Chess-nut/NovaRIde/IoT/NovaRide/PCB_PCB_bottomlayer.png

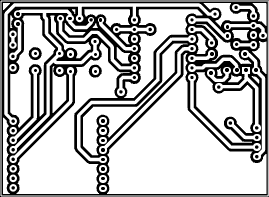
IoT/NovaRide/PCB_PCB_bottomlayer.png
