Chess-nut/NovaRIde/IoT/NovaRide/PCB_PCB_NovaRide_2026-10-28.png

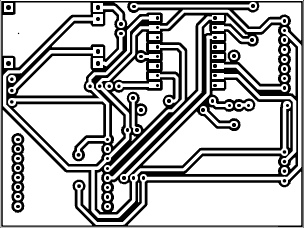
IoT/NovaRide/PCB_PCB_NovaRide_2026-10-28.png
