Chess-nut/NovaRIde/IoT/NovaRide/PCB_PCB_toplayer.png

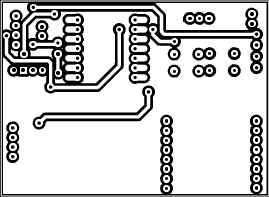
IoT/NovaRide/PCB_PCB_toplayer.png
