Chess-nut/NovaRIde/IoT/NovaRide/3D Files/MQ3_holder.stl

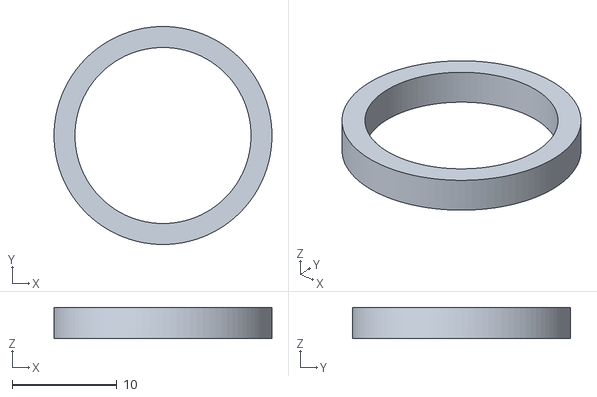
[picture p4: CAD file, 2026-10-30]
IoT/NovaRide/3D Files/MQ3_holder.stl
20.8 x 20.8 x 3.00
