Chess-nut/NovaRIde/IoT/NovaRide/3D Files/2_finger_gopro_mounting_piece_28mm_wide_finger_34mm_gap_3mm_base.stl

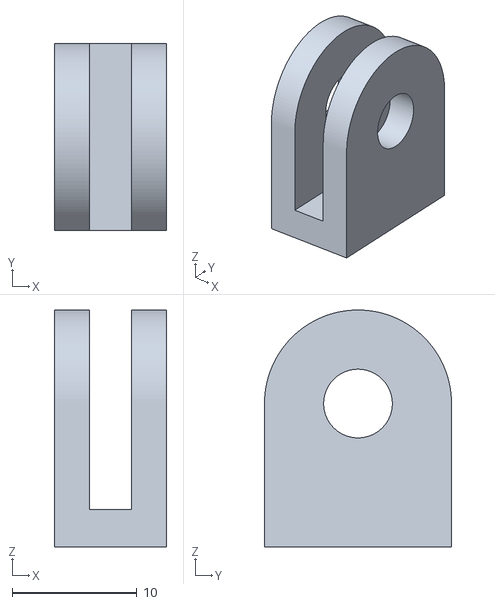
[picture p5: CAD file, 2026-10-30]
IoT/NovaRide/3D Files/2_finger_gopro_mounting_piece_28mm_wide_finger_34mm_gap_3mm_base.stl
9.00 x 15.0 x 19.0
