Chess-nut/NovaRIde/IoT/NovaRide/3D Files/Bottom.3mf

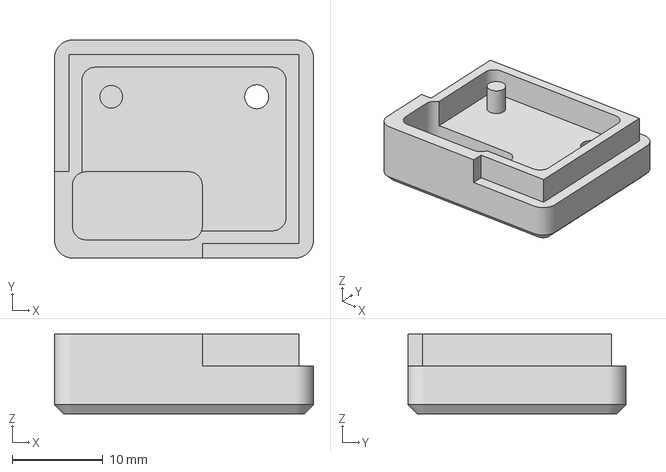
[picture p6: CAD file, 2026-10-30]
IoT/NovaRide/3D Files/Bottom.3mf
28.5 x 24.0 x 8.75 mm
