Chess-nut/NovaRIde/IoT/NovaRide/3D Files/TOP.3mf

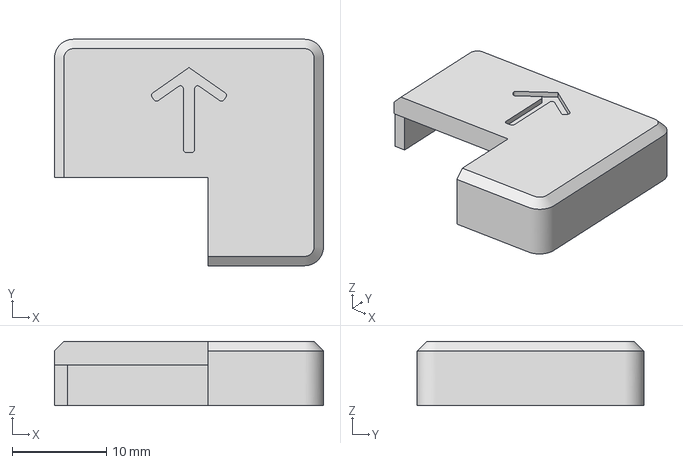
[picture p7: CAD file, 2026-10-30]
IoT/NovaRide/3D Files/TOP.3mf
28.5 x 24.0 x 6.80 mm
