Chess-nut/NovaRIde/IoT/NovaRide/3D Files/MOUNT.stl

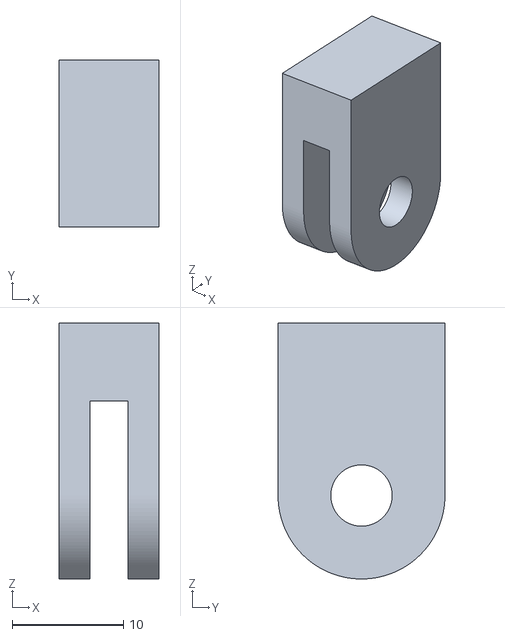
[picture p8: CAD file, 2026-10-30]
IoT/NovaRide/3D Files/MOUNT.stl
9.00 x 15.0 x 23.0
