Chess-nut/NovaRIde/IoT/NovaRide/3D Files/SweetProtection_Strutter_GoPro_Mount_v1.stl

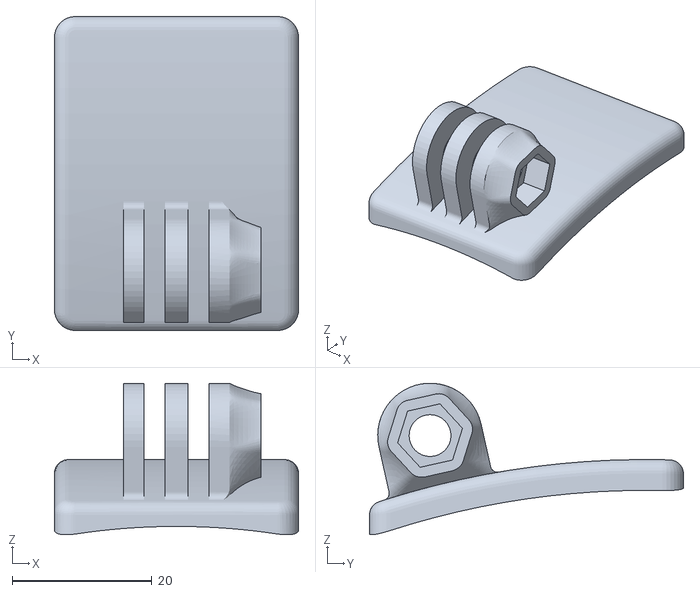
[picture p9: CAD file, 2026-10-30]
IoT/NovaRide/3D Files/SweetProtection_Strutter_GoPro_Mount_v1.stl
35.0 x 45.0 x 21.7
