Chess-nut/NovaRIde/IoT/NovaRide/3D Files/SW-420 Vibration Sensor Magnetic mount 8mm.stl

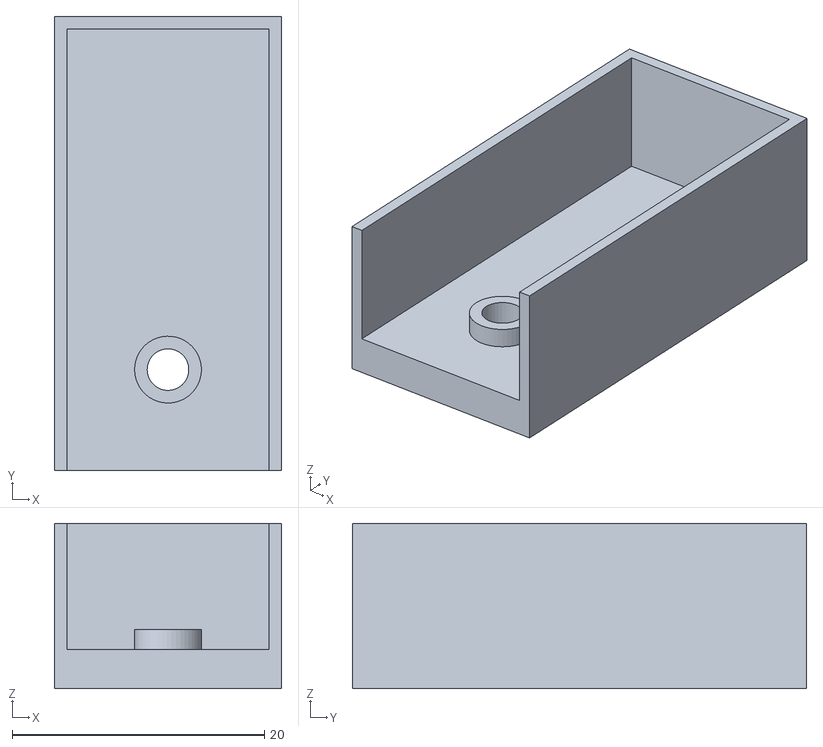
[picture p10: CAD file, 2026-10-30]
IoT/NovaRide/3D Files/SW-420 Vibration Sensor Magnetic mount 8mm.stl
18.0 x 36.0 x 13.1
