Chess-nut/NovaRIde/IoT/NovaRide/3D Files/caseV3.stl

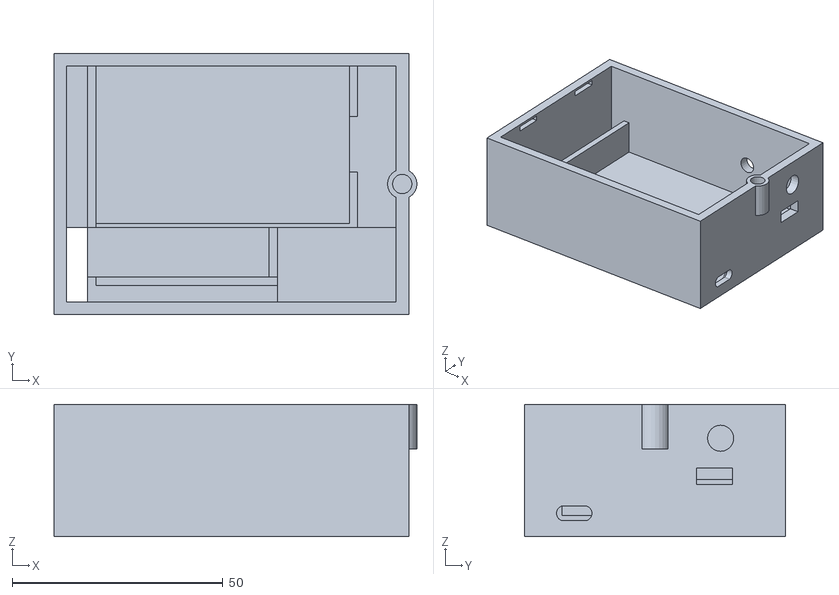
[picture p11: CAD file, 2026-10-30]
IoT/NovaRide/3D Files/caseV3.stl
86.0 x 61.9 x 31.3
