Chess-nut/NovaRIde/IoT/NovaRide/3D Files/case.stl

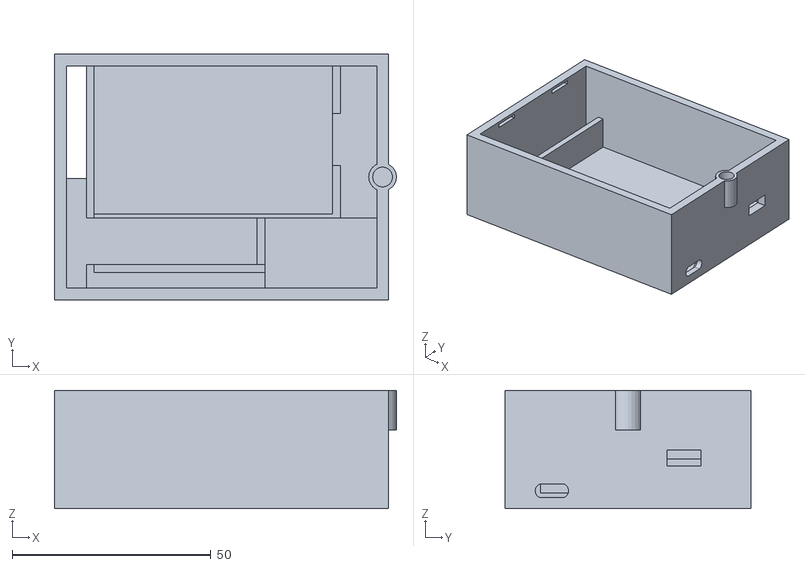
[picture p12: CAD file, 2026-10-30]
IoT/NovaRide/3D Files/case.stl
86.0 x 61.9 x 29.8
