Chess-nut/NovaRIde/IoT/NovaRide/3D Files/COVER.stl

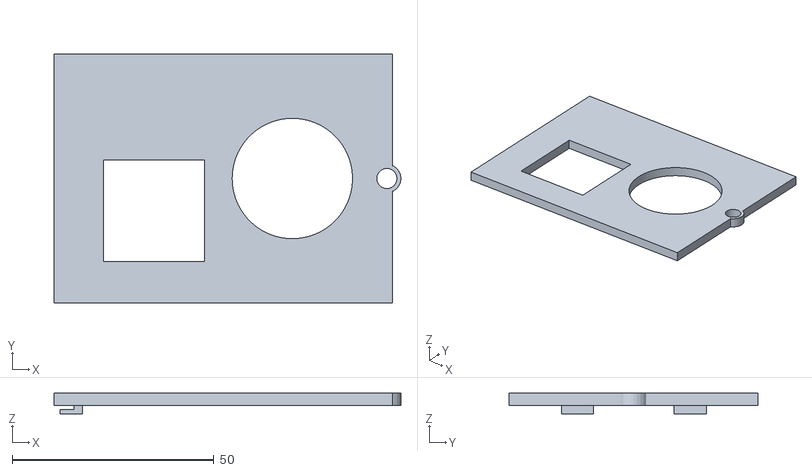
[picture p13: CAD file, 2026-10-30]
IoT/NovaRide/3D Files/COVER.stl
85.9 x 61.7 x 5.11
