Chess-nut/NovaRIde/(list of files, cad)

Other CAD files:
IoT/NovaRide/3D Files/caseV2.stl
IoT/NovaRide/3D Files/novaride.skp
