Chess-nut/NovaRIde/(commit log)

2026-07-29 innit: feat(admin): Phase 1 dashboard shell with mock fleet data
    Flutter Web operations console behind lib/main_admin.dart, sharing
    NovaColors with the rider app. No new pub dependencies, no Firebase.
    - shared/models: Rider, HelmetTelemetry, AlertEvent + status enums
    - admin/mock: 10 riders, matching telemetry, 5 alerts, weekly counts
    - AdminLoginPage (admin@novaride.ph / admin123) -> AdminShell
    - AdminShell: 240px sidebar (icon rail below 900px), topbar with LIVE
    indicator and admin chip, IndexedStack page switching, no router
    - DashboardPage: KPI row computed from the mock data, live fleet table
    (emergency rows red-tinted, alcohol over 0.05 in amber), map
    placeholder, alert feed, an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
2026-07-29 feat(admin): ArcGIS-style ops dashboard with live mock simulation
    Replaces the Phase 1 KPI-and-cards dashboard with a dense ops-console grid:
    a donut and an area chart flanking a large stylized fleet map, over a row of
    alert feed + two derived bar charts.
    All six panels read from one MockFleetController, so a simulated crash lands
    in the feed, flips a rider red on the map, and moves the donut and priority
    chart in the same frame. That controller is the seam Firebase streams plug
    into at Phase 4.
    - Shared DashPanel chrome and a single SimpleBarChartPainter behind all three
    bar charts; everything else hand-painted, no new dependencies.
    - AlertEvent gains an address; Rider/HelmetTelemetry g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
2026-08-08 feat(admin): rider CRUD with validation and roster filtering
2026-09-15 refactor(admin): extract FleetRepository seam
    Split the 635-line MockFleetController into a persistence contract and
    a source-agnostic controller so a cloud store can be swapped in without
    touching the pages.
    - lib/admin/data/fleet_repository.dart: FleetRepository interface —
    watch* streams as the source of truth, narrow write methods, and a
    FleetSource/FleetConnection surface for the top-bar chip.
    - lib/admin/data/mock_fleet_repository.dart: the simulation (jitter,
    alert spawner, stand-down rule) moved here unchanged. Streams deliver
    synchronously so controller and widget tests stay synchronous.
    - lib/admin/data/fleet_geography.dart: district table and map window,
    shared by the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
2026-09-15 feat(admin): Cloud Firestore repository with mock fallback
    The TNVS Operator console can now run on Cloud Firestore (project
    novaride-266bc) while keeping the in-process simulation as the
    zero-config default. Which one is live is shown in the top bar.
    - lib/admin/data/firestore_fleet_repository.dart: FleetRepository over
    riders/, devices/, alerts/ (orderBy timestamp, limit 100) and a
    history collection-group listener. Devices are joined to riders by
    helmetId; history is stitched onto alerts. Defensive parsing: missing
    fields default, unreadable documents are skipped with a debugPrint.
    Writes use update() with explicit paths or set(merge); a transition
    is one batch (status update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
2026-09-20 chore(admin): remove hardcoded Firebase project id
    The project moved from novaride-266bc to novaride-7a68c. Rather than swap
    one literal for another, FleetBootstrap.resolve() now returns a
    ConsoleBackend carrying the project id it read from
    assets/config/firebase.json, and the top bar's source tooltip shows that.
    The id no longer appears anywhere in lib/, so it cannot drift again.
    .firebaserc points at the new project. FIRESTORE_SCHEMA.md gets the new
    header and console link, notes that the old project's phantom users/*,
    emergencyalerts and devices/helmet01 structures are gone, flags that the
    composite indexes have to be deployed again, and closes the two §7 items
    that starting from an emp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
2026-09-20 feat(admin): Firebase Auth operator login with role claims and scoped rules
    Closes the panel comment "login - static only". The console's sign-in was
    a string comparison against three passwords in source, which is why the
    Firestore rules had to be deny-all: there was no principal to trust.
    Auth behind an interface, mirroring FleetRepository: AdminAuth with
    signIn / signOut / authStateChanges / currentUser. FirebaseAdminAuth is
    the real thing; LocalAdminAuth wraps the old demoAccounts so a checkout
    with no Firebase config - and every widget test - still signs in without
    the network. FleetBootstrap.resolve() now decides data source and auth
    together as one ConsoleBackend; AdminApp owns the si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
2026-09-20 feat(admin): production-grade operator login screen
    The login page listed every operator account with a role badge and a
    tap-to-fill row. That was a development convenience; on the front door
    of an operations console it reads as a prototype and hands an
    unauthenticated visitor the operator roster. The card is gone, on both
    paths, and the real operator emails it was built from
    (provisionedOperators) are gone from the repository with it.
    In its place, the things an operations tool actually has:
    - "Remember my email on this browser" keeps the last address — never
    the password — in localStorage via dart:js_interop (no package; an
    in-memory stub serves the VM), and a returning operator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
2026-09-20 fix(admin): resolve empty-state overflow at short viewport heights
    The Alerts page sized its KPI row to the page's outer width instead of
    the width inside its own 16px padding, so the fifth card was 32px short
    of fitting and wrapped onto a second row at every width — 170px taken
    from the queue below. On a 1366-wide window that is wide enough for the
    fixed-height layout and 633 tall, the queue's empty state was left a
    3px slot and overflowed. (At exactly 1280 the sidebar leaves the page
    under its 1100px breakpoint, so it scrolls and the stripe never shows;
    the observed size was a laptop mirroring the projector.)
    Three fixes, each structural rather than a smaller icon:
    - The KPI row is siz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
2026-09-20 feat(admin): persist rider registration and device pairing to Firestore
    Audit first: register, edit and deactivate already reached riders/ on
    the Firestore path (set-with-merge, update by field path, update), and
    survived a reload through the riders listener. Not rebuilt. What was
    missing: the helmet pairing was never written to devices/ (and the
    rules would have refused it); rider ids and helmet uniqueness were
    checked only against this console's copy of the roster; a plain write
    issued while offline queued forever with the rider on screen as saved;
    and a refused write showed the raw exception string.
    Repository (FirestoreFleetRepository): every roster write is one
    transaction. addRider cl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
2026-11-06 fix(admin): read every RTDB helmet node and replace the painted map
    - Merge deviceStatus, devices/{id}/safety|tracking|latest and the last 10
    trackingLogs/gpsLogs entries per helmet (rtdb_fleet_merge.dart, ported
    from the rider app); publish RTDB telemetry without waiting for
    Firestore devices/
    - Extend HelmetTelemetry with every firmware field; nulls show as a dash
    - Derive rider status from the helmet (offline after 2 min, riding at
    >= 5 km/h, emergency on crash/SOS) without writing it back
    - Nullable alert positions: last known fix or "Location unavailable",
    districts only within 3 km, "Outside coverage" bucket
    - Helmet-reported events tagged "Unconfirmed - from helmet" with an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
